Hani256/smart-fan/hardware/board.stl

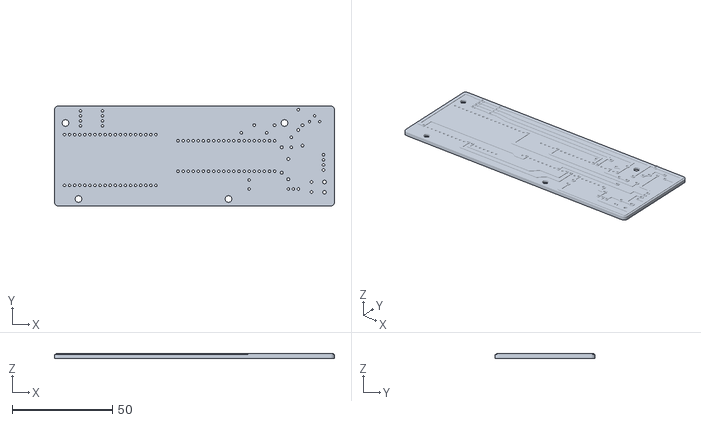
[picture p6: CAD file, 2026-10-30]
hardware/board.stl
140.0 x 50.0 x 2.60
