Hani256/smart-fan/hardware/enclosure/fan_frame.stl

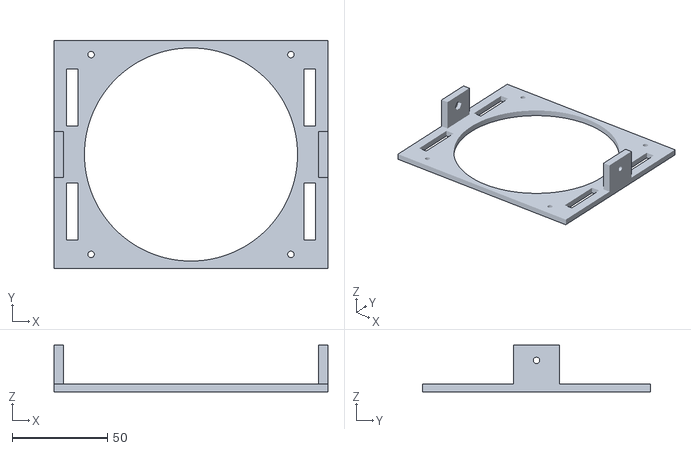
[picture p7: CAD file, 2026-10-30]
hardware/enclosure/fan_frame.stl
144.0 x 120.0 x 24.5
