Hani256/smart-fan/hardware/enclosure/plunger.stl

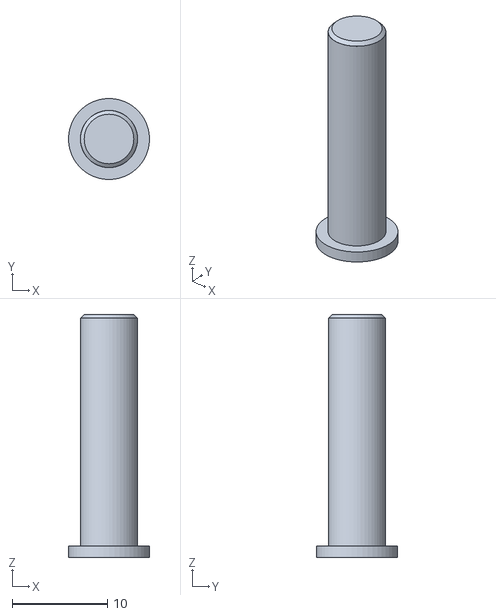
[picture p8: CAD file, 2026-10-30]
hardware/enclosure/plunger.stl
8.50 x 8.50 x 25.5
