Hani256/smart-fan/hardware/enclosure/lid.stl

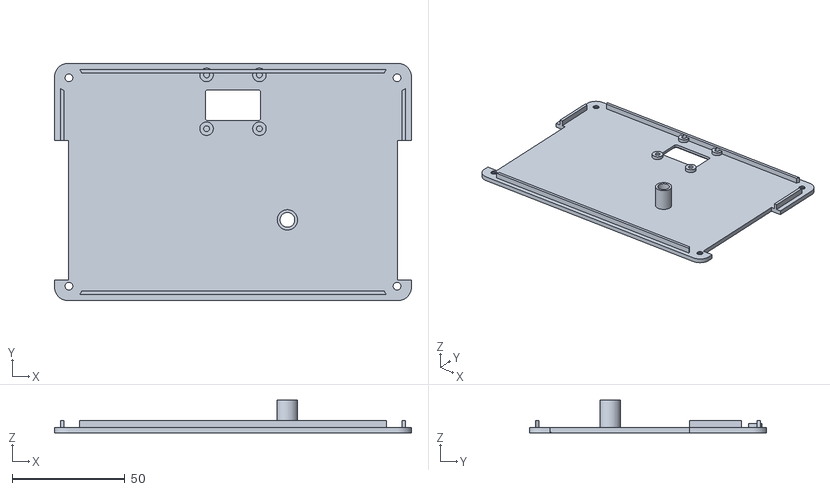
[picture p9: CAD file, 2026-10-30]
hardware/enclosure/lid.stl
158.0 x 105.0 x 14.4
