Hani256/smart-fan/hardware/enclosure/base.stl

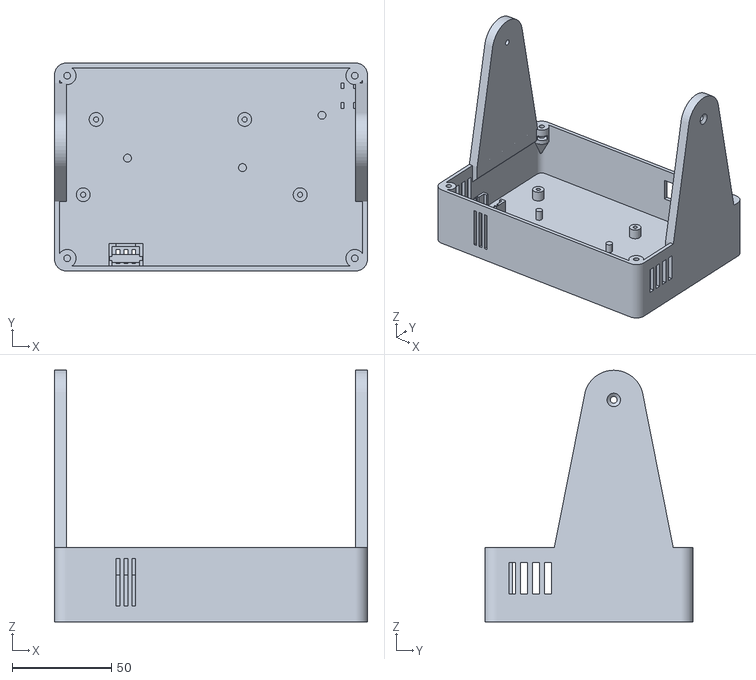
[picture p10: CAD file, 2026-10-30]
hardware/enclosure/base.stl
158.0 x 105.0 x 127.0
