Hani256/smart-fan/esp32/src/secrets.example.h

#pragma once
// Copy this file to secrets.h and fill it in. secrets.h is not in git.
#define WIFI_SSID "your-wifi-name"
#define WIFI_PASS "your-wifi-password"
#define OTA_PASS "choose-an-ota-password"
#define MQTT_HOST "192.168.0.5" // the Mac running the broker
#define MQTT_USER "smartfan"
#define MQTT_PASS "the-broker-password"
