Hani256/smart-fan/(commit log)

2026-09-28 Blink LED from FreeRTOS task
2026-09-28 I2C bus working: AHT20, BMP280, OLED found
2026-09-28 Read temperature and humidity from AHT20
2026-09-29 Fan PWM control, tach RPM, OLED shows temp, humidity and RPM
2026-10-10 Temperature PID sets the fan duty
2026-10-10 Run the fan loop on a fixed period
2026-10-13 Trust the temperature only while it is fresh, and define a safe state
2026-10-21 Kick-start the fan at full power when it starts from standstill
2026-10-28 Share readings through mailboxes, and bring the sensor back after a disconnect
    The tasks no longer share volatile globals. SensorTask writes each reading
    together with its timestamp into a one item queue with xQueueOverwrite, and
    FanTask peeks at it, so it can never see a new temperature next to an old
    timestamp. FanTask hands duty and RPM back to the screen the same way.
    An AHT20 that is unplugged and plugged back in used to stay dead. After three
    failed rounds in a row the I2C peripheral is now rebuilt and the sensor gets
    its calibrate command again.
2026-10-28 Pull the tach line up inside the MCU
    The fan's tach output is open collector, so something has to pull it high
    between pulses. The new board has no resistor for it and relies on the
    internal pull-up on PA5, which was still set to no pull. Set it in the .ioc
    too, so the next regeneration keeps it.
2026-10-28 Put the LED task below the sensor and fan tasks
    CubeMX had created the blink task at osPriorityNormal, which is 24, while the
    sensor and fan tasks were at 1 and 2. It barely mattered because the blink
    task sleeps almost all the time, but the least important task should not be
    able to run ahead of the fan. Move the blink task to osPriorityLow and give
    the two application tasks CMSIS priorities above it, so all three are on the
    same scale.
2026-10-28 Bring the README up to date with the board and the code
    The control section still described the PID, and the hardware section still
    described a MOSFET. Describe the curve that replaced the PID, the transistor
    on the fan's PWM wire and why the timer output is active low, the button and
    UART pins, and move the finished items out of the plan.
2026-10-29 Filter the tach line in hardware and in the interrupt
    The new board's tach line sits on the internal pull-up only, and the RPM
    reading once showed 348000, which is noise and not the fan. TIM2's input
    filter now runs at its strongest setting, so a level has to be stable for
    about 11 us before it counts, and the interrupt ignores any edge that comes
    less than 5 ms after the last counted one. That is 6000 rpm, far above what
    the fan can reach.
    [smart_fan.ioc]
2026-10-29 Name the fan correctly: it is a P12 Pro
    The README called it a P12 PWM, and the comment on the tach gap assumed a
    slower fan. It is a P12 Pro, rated for 3000 rpm, and at full duty the tach
    reads about 3030, so that is also the check that the count is right.
2026-10-29 Send a status line to the ESP32 once a second
2026-10-29 ESP32: receive the status line from the STM32 and check it
2026-10-30 ESP32: join the home WiFi and show the fan on a web page
2026-10-30 ESP32: update over WiFi, and keep retrying when the router refuses
2026-10-30 ESP32: a proper dashboard page, kept in its own file
2026-10-30 Auto, manual and off modes, switched with the button
2026-10-30 Take mode commands from the ESP32, and report the mode back
2026-10-30 ESP32: switch modes and set the manual speed from the page
2026-10-30 Move the fan logic out of the task, so it can be tested without the board
2026-10-30 Unit tests for the fan logic and the link protocol
2026-10-30 Fix two bugs the tests found: manual speed below 30 % surged, and a space passed as a checksum digit
    [fan_control.c, link_proto.c]
2026-10-30 README: the printed board, the architecture, the tests
    [base.stl, board.stl, fan_frame.stl, lid.stl, plunger.stl]
2026-10-30 Move the BOM and the board guide up into hardware/
2026-10-30 Hold the start speed in the hysteresis band instead of a negative cast
    When the fan was running and the temperature fell between FAN_T_OFF and
    FAN_T_ON, the curve came out negative and was cast to uint8_t, which is
    undefined behaviour. The sanitizer build caught it in the existing
    hysteresis test. Between the two thresholds the fan now stays at
    FAN_DUTY_START, it still stops at once at FAN_T_OFF, and the curve from
    FAN_T_ON up is unchanged.
2026-10-30 Return -1 when the status line does not fit, and never send that
    link_format_status used the first snprintf result for buf + n and size - n
    without checking it. In a buffer too small for the line, n was larger than
    size, the second write went past the end and the checksum read past it too.
    AddressSanitizer shows the overflow with the old code. Now a NULL buffer, a
    size of 0 or any truncation returns -1 before any pointer arithmetic, and
    leaves an empty string in buf. LinkTask skips the round on -1 instead of
    handing the value to DMA as a length, and its buffer uses the new
    LINK_STATUS_MAX_LEN, which fits the longest line the format can produce.
    [link_proto.c, link_proto.h]
2026-10-30 LinkTask: start from a zeroed sensor sample, so a missing sensor gives a clean stale line
2026-10-30 ESP32: check status lines strictly, and only believe a line that passes
    The ESP32 accepted a checksum followed by anything, read the fields with
    sscanf, which stops quietly at the first surprise and wraps on overflow, and
    counted a line as good and as a sign of life before it had parsed it.
    The parsing now lives in lib/status_parse, plain C with no Arduino
    dependency, so the host tests build it too. A line must have exactly two hex
    checksum digits and nothing after them, exactly the fresh or the stale
    layout, digits only, and every value in range: temperature as the STM32
    keeps it (above -20 C, below 80 C), humidity 0 to 100 %, duty 0 to 100,
    rpm within 32 bits, mode A, M or O. Only then ar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
2026-10-30 Page: show "ESP32 not reachable" when the device is switched off
    A request to a device that is switched off is never answered, and the
    browser waits a long time before it gives up. Until then the page kept
    showing the last values and "Live". Each request now gives up after 2 s,
    the next one only starts when the last one has finished, and if nothing has
    answered for 3 s the page says so and shows dashes instead of old numbers.
2026-10-31 ESP32: publish state over MQTT and take mode commands
    Publishes every status line to smartfan/state (retained), online/offline on smartfan/status with a Last Will, and accepts A, O and M,<0-100> on smartfan/mode/set. The page footer shows the broker connection.
    [main.cpp, secrets.example.h]
